jacobchesley/Rover_2015/Arduino/README.md

# Arduino source code and documentation #

## doc ##
Documentation for custom Arduino libraries used for the rover.  To open documentation, open doc/documentation.html in your browser.

## src ##
Source code for rover and custom libraries.
