jacobchesley/Rover_2015/Arduino/src/README.md

# Source code for Arduino #

## Custom Libraries folders ##
* Accelerometer (ADXL345 custom library)
* Compass (MAG3110 custom library)
* Motors (L298N custom library)
* Solenoids (Custom solenoid driver library)
* Sonar (HC-SR04 custom library)

## Rover source code folder ##
* Rover (rover source code)
