jacobchesley/Rover_2015/Arduino/doc/latex/md__e_1__development__stratocats__arduino_src__r_e_a_d_m_e.tex

\subsection*{Custom Libraries folders}

\begin{DoxyItemize}
\item \hyperlink{class_accelerometer}{Accelerometer} (A\+D\+X\+L345 custom library)
\item \hyperlink{class_compass}{Compass} (M\+A\+G3110 custom library)
\item \hyperlink{class_motors}{Motors} (L298\+N custom library)
\item \hyperlink{class_solenoids}{Solenoids} (Custom solenoid driver library)
\item \hyperlink{class_sonar}{Sonar} (H\+C-\/\+S\+R04 custom library)
\end{DoxyItemize}

\subsection*{Rover source code folder}

\begin{DoxyItemize}
\item Rover (rover source code) 
\end{DoxyItemize}
