jacobchesley/Rover_2015/Electrical/Diagrams/Block Diagrams/rover block diagram.png

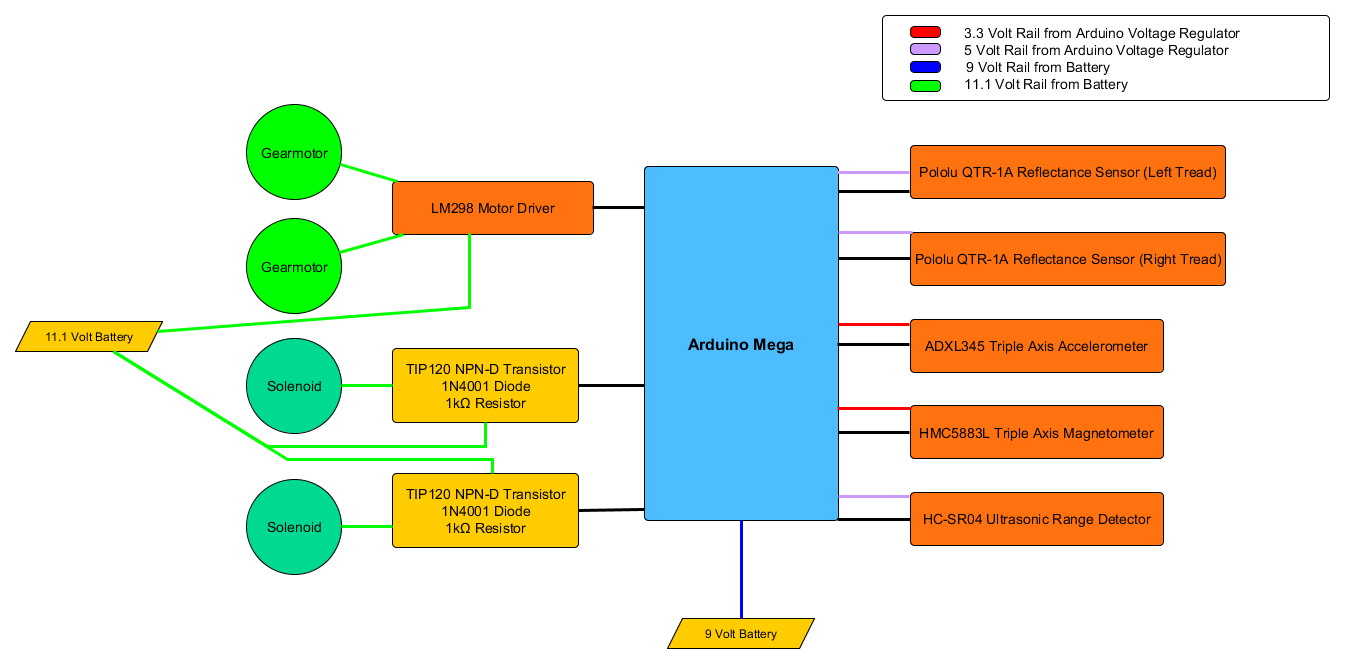
Electrical/Diagrams/Block Diagrams/rover block diagram.png
