jacobchesley/Rover_2015/Electrical/Diagrams/Flow Charts/1 Launch Detection.png

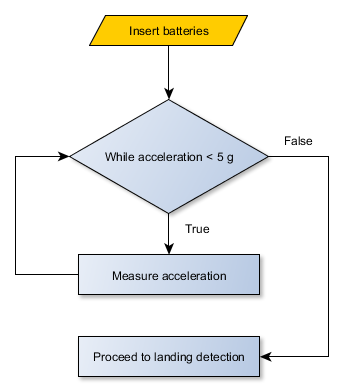
Electrical/Diagrams/Flow Charts/1 Launch Detection.png
