jacobchesley/Rover_2015/Electrical/Diagrams/Flow Charts/2 Landing Detection.png

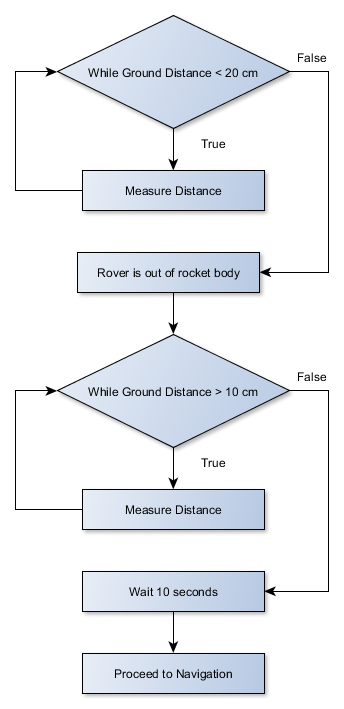
Electrical/Diagrams/Flow Charts/2 Landing Detection.png
