jacobchesley/Rover_2015/Electrical/Diagrams/Flow Charts/Navigation.png

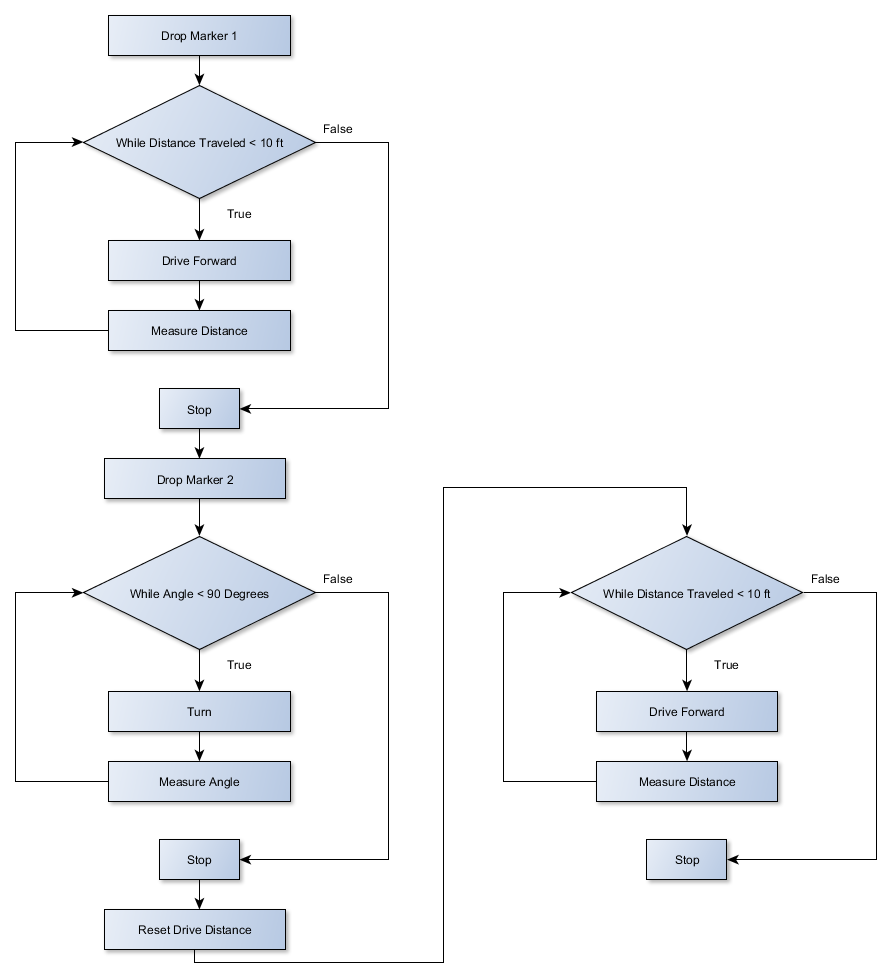
Electrical/Diagrams/Flow Charts/Navigation.png
