jacobchesley/Rover_2015/Electrical/Diagrams/rover.png

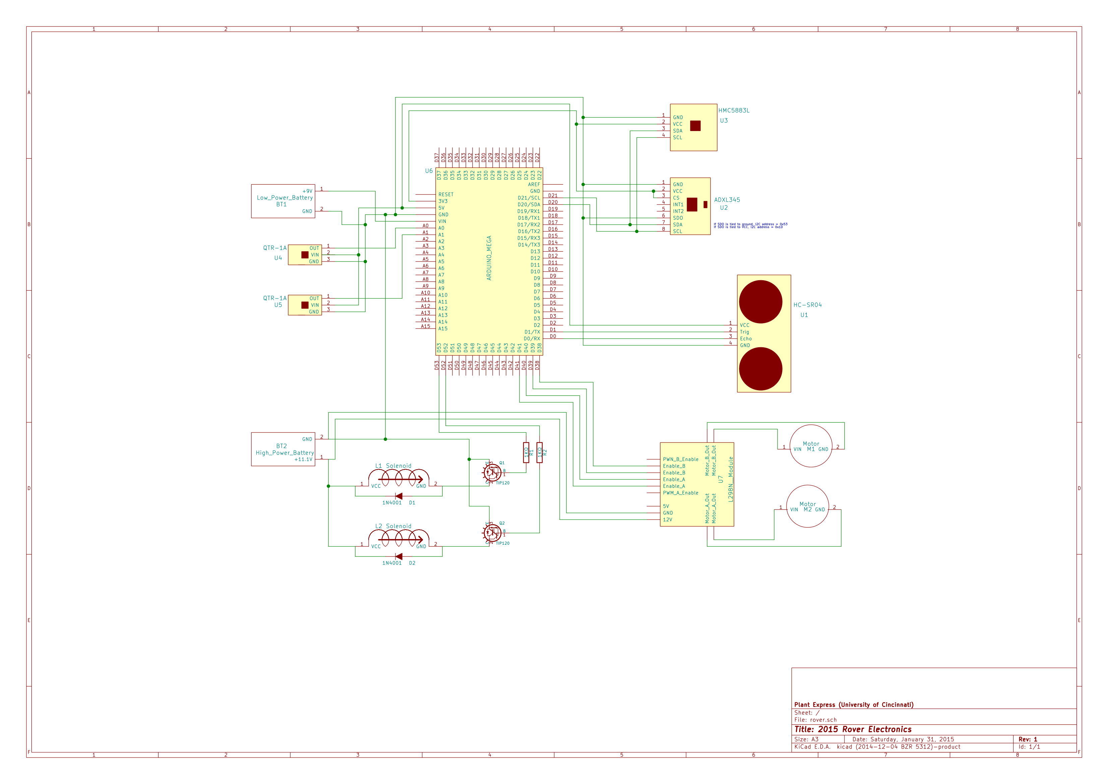
Electrical/Diagrams/rover.png
