jacobchesley/Rover_2015/Electrical/PCB Render/rover_back.png

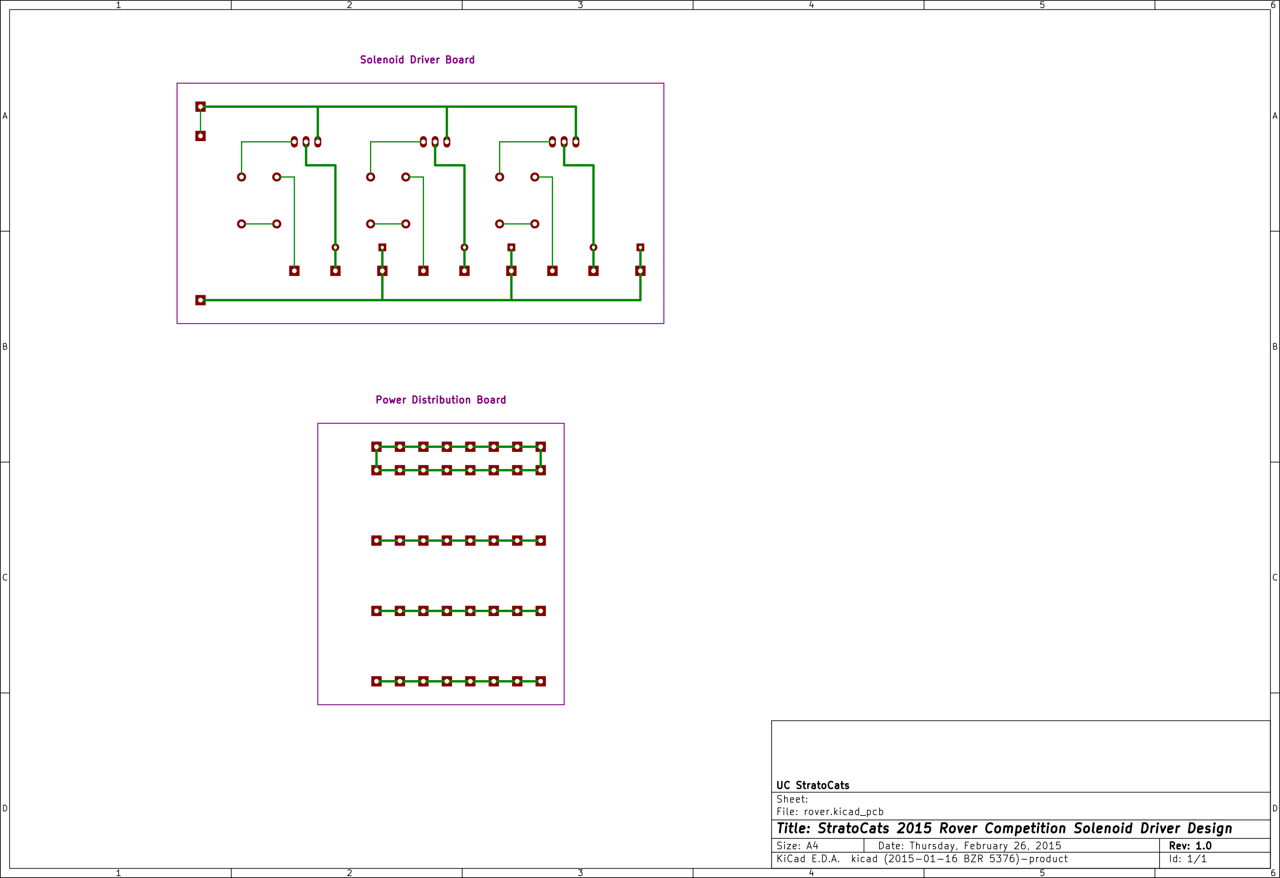
Electrical/PCB Render/rover_back.png
