jacobchesley/Rover_2015/Electrical/Rover_BOM.xlsx

Reference | Value | Cost | Order Website | Description | Comments
U6 | ARDUINO_MEGA | $0.00 | Already Acquired | Microcontroller for rover
U2 | ADXL345 | $17.95 | https://www.sparkfun.com/products/9836 | Accelerometer to sense takeoff and landing | Included breakout board
U1 | HC-SR04 | $6.34 | https://www.amazon.com/SainSmart-HC-SR04-Ranging-Detector-Distance/dp/B004U8TOE6 | Ultrasonic distance sensor to check for landing
U4 | QTR-1A | $4.25 | https://www.pololu.com/product/2458 | Reflectance sensor placed on tread 1 to sense distance traveled | 2 PACK
U5 | QTR-1A | $0.00 | Included in 2 pack above | Reflectance sensor placed on tread 2 to sense distance traveled | included in 2 pack above
U3 | HMC5883L | $14.95 | https://www.sparkfun.com/products/10530 | Magnetometer to sense direction of rover | Included breakout board
L1 | Solenoid | $4.95 | https://www.sparkfun.com/products/11015 | Solenoid to release first marker
L2 | Solenoid | $4.95 | https://www.sparkfun.com/products/11015 | Solenoid to release second marker
R2 | 1KΩ | $0.99 | http://www.jameco.com/webapp/wcs/stores/servlet/Product_10001_10001_690865_-1 | Resistor to limit current on transistor for solenoid 1 activation | Must order at least 10 at $0.099 each
R1 | 1KΩ |  | Included in 10 pack above | Resistor to limit current on transistor for solenoid 2 activation
D1 | 1N4001 | $0.50 | http://www.jameco.com/webapp/wcs/stores/servlet/Product_10001_10001_35975_-1 | Diode to prevent flyback voltage from solenoid 1 | Must order at least 10 at $0.05 each
D2 | 1N4001 | $0.00 | Included in 10 pack above | Diode to prevent flyback voltage from solenoid 2
Q1 | TIP120 | $0.49 | http://www.jameco.com/webapp/wcs/stores/servlet/Product_10001_10001_32994_-1 | Transistor to activate solenoid 1 from arduino digital output
Q2 | TIP120 | $0.49 | http://www.jameco.com/webapp/wcs/stores/servlet/Product_10001_10001_32994_-1 | Transistor to activate solenoid 2 from arduino digital output
BT2 | High_Power_Battery
BT1 | Low_Power_Battery
