jacobchesley/Rover_2015/Electrical/rover.pdf

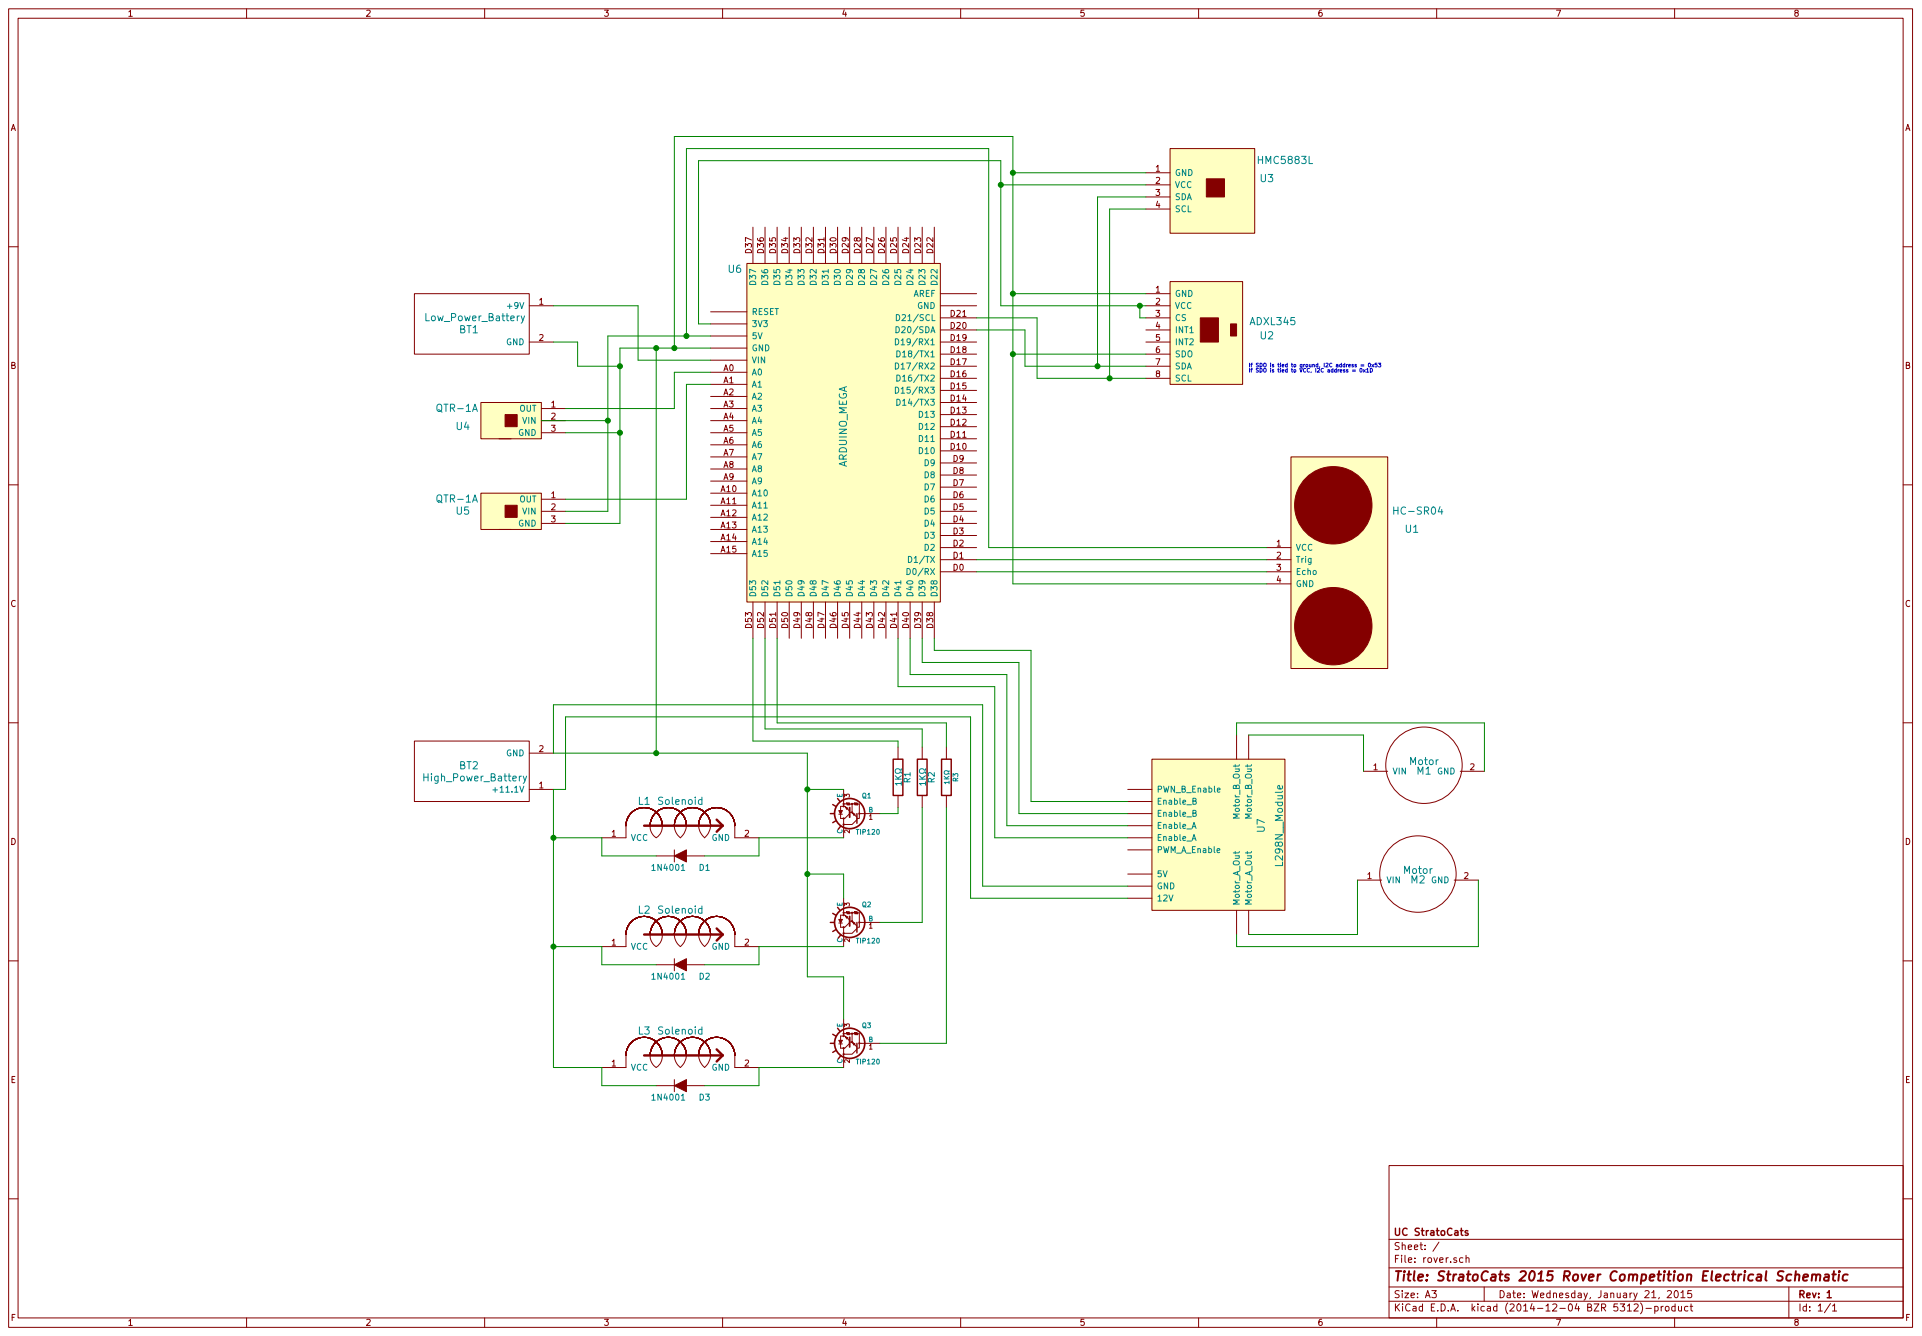
[picture p7: page 1]

GND 1 VCC 2 CS 3

INT1 4

If SDO is tied to ground, I2C address = 0x53

File: rover.sch Sheet: / UC StratoCats

Id: 1/1 Title: StratoCats 2015 Rover Competition Electrical Schematic
