jacobchesley/Rover_2015/Electrical/Diagrams/rover.pdf

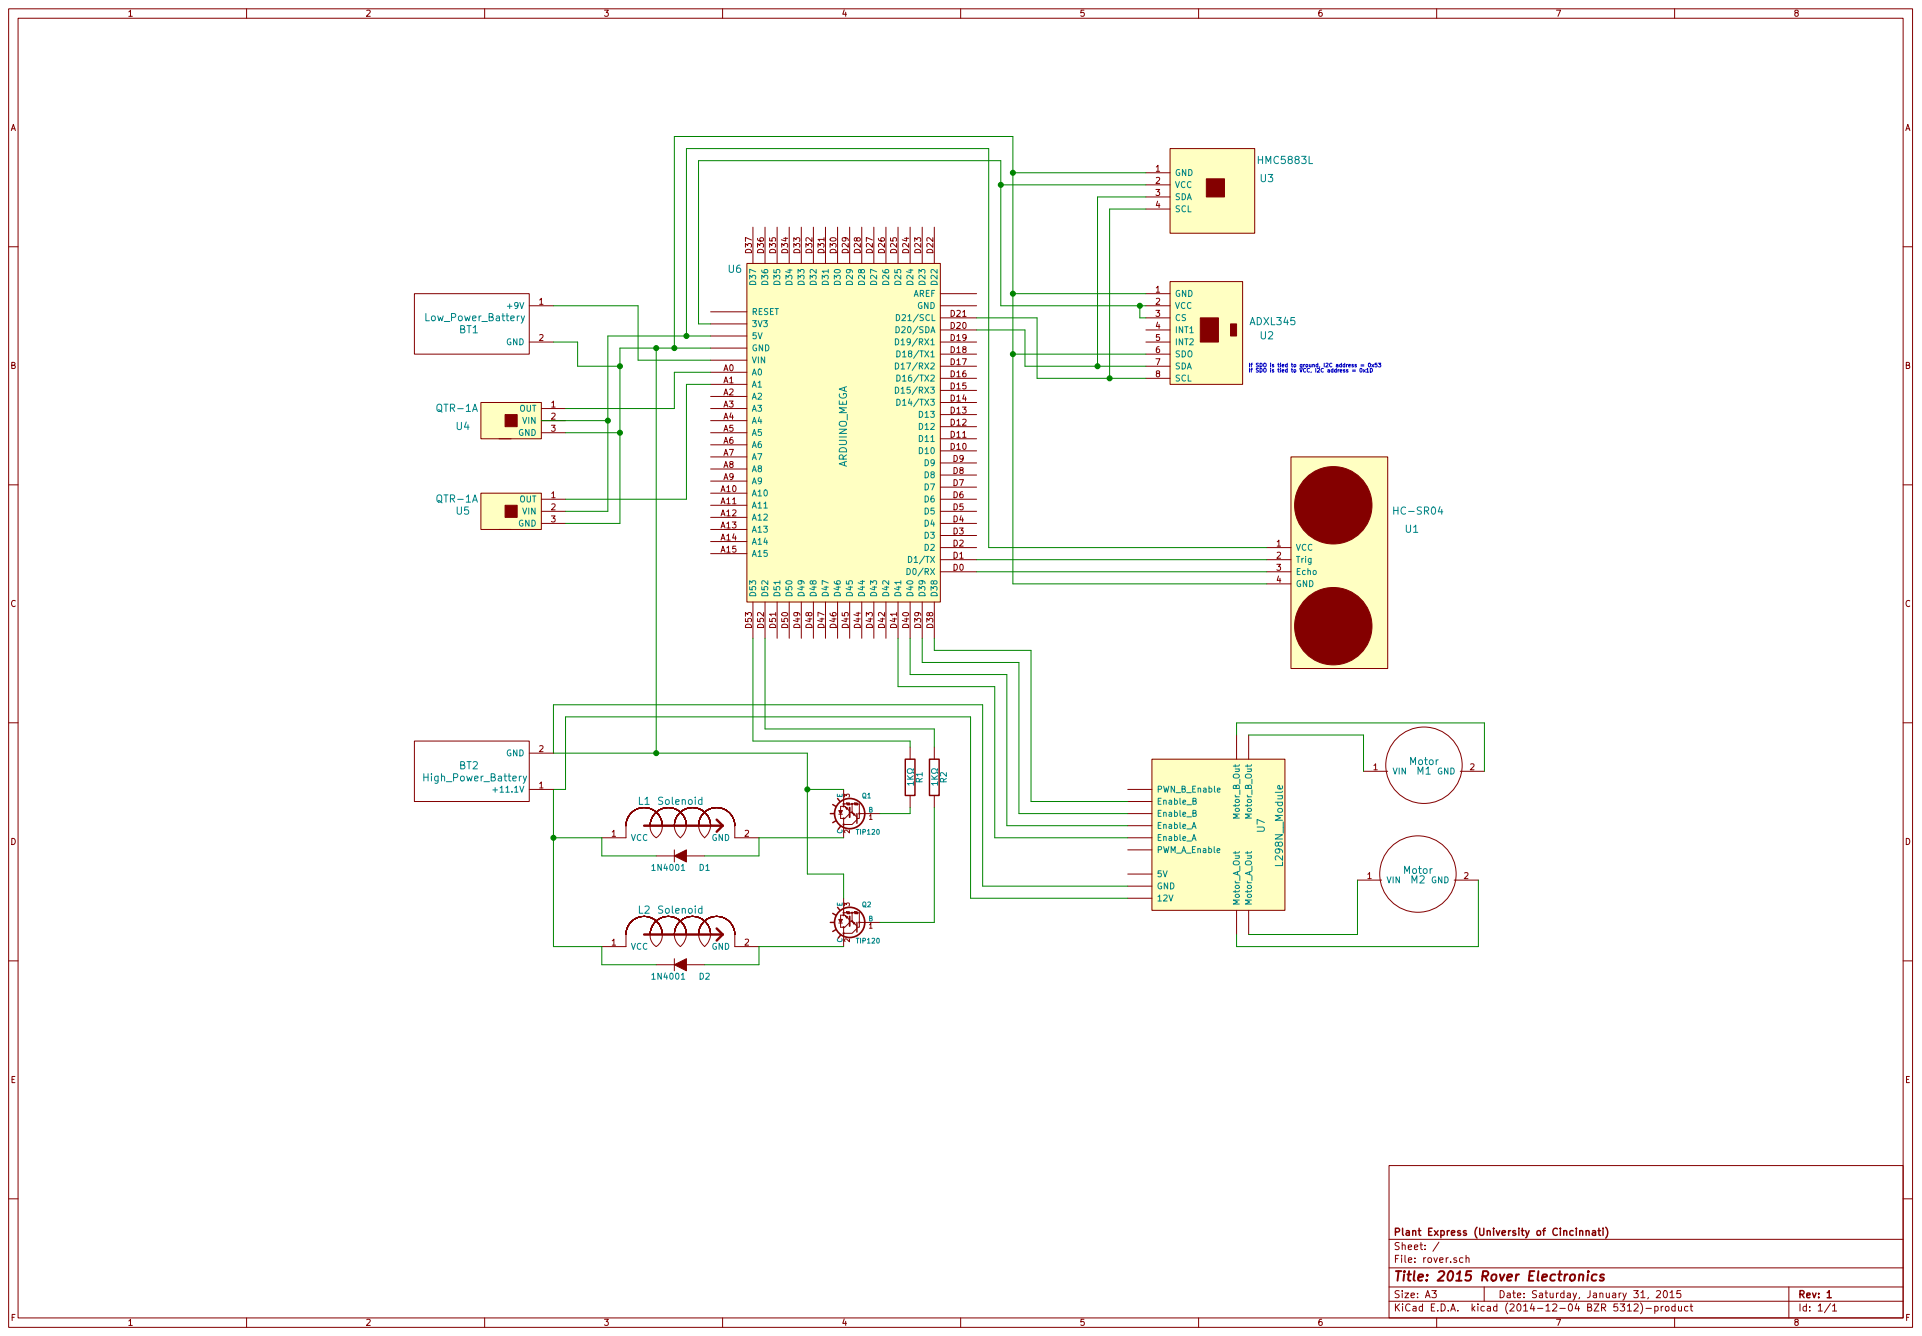
[picture p8: page 1]

GND 1 VCC 2 CS 3

INT1 4

If SDO is tied to ground, I2C address = 0x53

File: rover.sch Sheet: / Plant Express (University of Cincinnati)

Id: 1/1 Title: 2015 Rover Electronics
