jacobchesley/Rover_2015/Electrical/rover.sch

## KiCad design Electrical/rover.sch (2015-02-25)

Schematic: rover.sch

Parts:
BT1: Low_Power_Battery
BT2: High_Power_Battery
D1, D2, D3: 1N4001
L1, L2, L3: Solenoid
M1, M2: Motor
Q1, Q2, Q3: TIP120; TO220
R1, R2, R3: 1KΩ
U1: HC-SR04
U2: ADXL345
U3: HMC5883L
U4, U5: QTR-1A
U6: ARDUINO_MEGA
U7: L298N__Module

Notes on the sheet:
If SDO is tied to ground, I2C address = 0x53 If SDO is tied to VCC, I2C address = 0x1D
