jacobchesley/Rover_2015/(commit log)

2015-01-20 Initial upload
    [rover.kicad_pcb, rover.sch]
2015-01-20 Add KiCad lib files for specific rover KiCad components
2015-01-20 Update rover
    [Rover_BOM.xlsx, rover.csv]
2015-01-20 Add KiCad BOM capabilities
2015-01-21 Update schematic and BOM
    [Rover_BOM.xlsx, rover.sch]
2015-01-21 Update PDF schematic
2015-02-03 Motor and motor controller added, and block diagrams and flowcharts created
    [rover.csv, rover.sch]
2015-02-26 Add larger trace widths to Solenoid Driver Board. Add power distribution board.
    [rover.kicad_pcb]
2015-02-28 add schematic PDF
2015-03-03 Thicken trace widths for better toner transfer quality
    [rover.kicad_pcb]
2015-03-12 Initial rover arduino source code upload
2015-03-12 Modify directory structures
    [Rover_BOM.xlsx, rover.csv, rover.kicad_pcb, rover.sch]
2015-03-12 Add rover and arduino cad libraries
2015-03-12 Fixed corrupted kicad file
2015-03-12 Rename rover arduino file
2015-03-12 Initial commit for custom motors library
2015-03-12 Added documentation to motor library
2015-03-12 Add custom solenoid controller library
2015-03-13 Add custom accelerometer library
2015-03-13 Add custom libraries for Motor, Solenoid and Accelerometer
2015-03-13 Fixed comment on Solenoids::Disable - digitalWrite line
    [Solenoids.cpp]
2015-03-14 Add sonar library
